edufiedler/AndreEduardoEzequiel/images/03_tampa_descobeta.jpeg

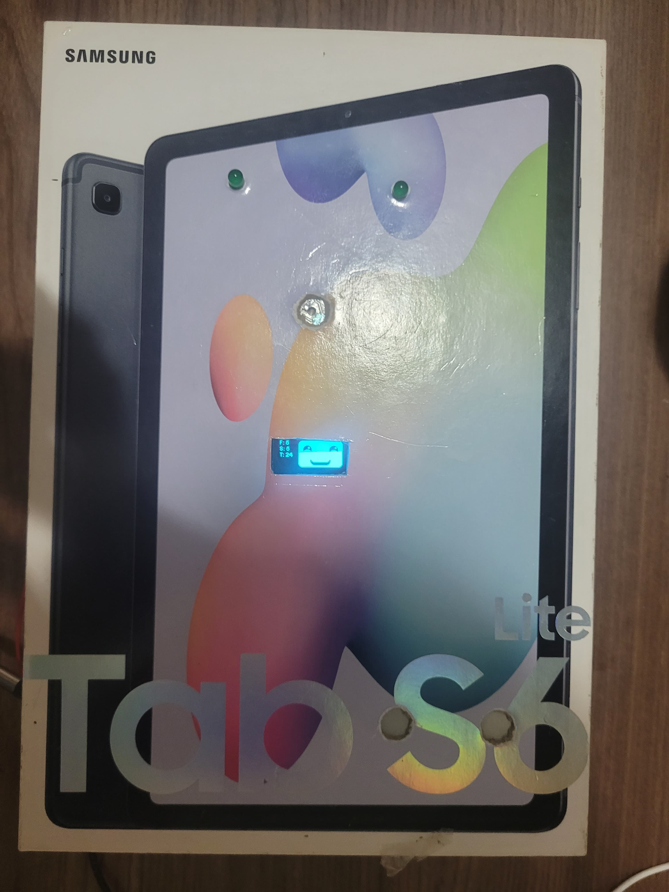
images/03_tampa_descobeta.jpeg
