edufiedler/AndreEduardoEzequiel/(threads)

Thread 1 (2023-11-17):

conteúdo

FNakano, 2023-11-17:
Caros, poderiam adicionar conteúdo?
   Sei que vocês tem testado alguns sensores e exemplos de codigo. Poderiam registrar os testes no formato de diário e documentar a proposta do pet virtual, se possivel descrever as funcionalidades desejadas e ligar com os testes...
att.
