edufiedler/AndreEduardoEzequiel/prototipo.pdf

214 | 25 | Aparência do tamagotchi Cotas para posicionamento dos equipamentos na caixa

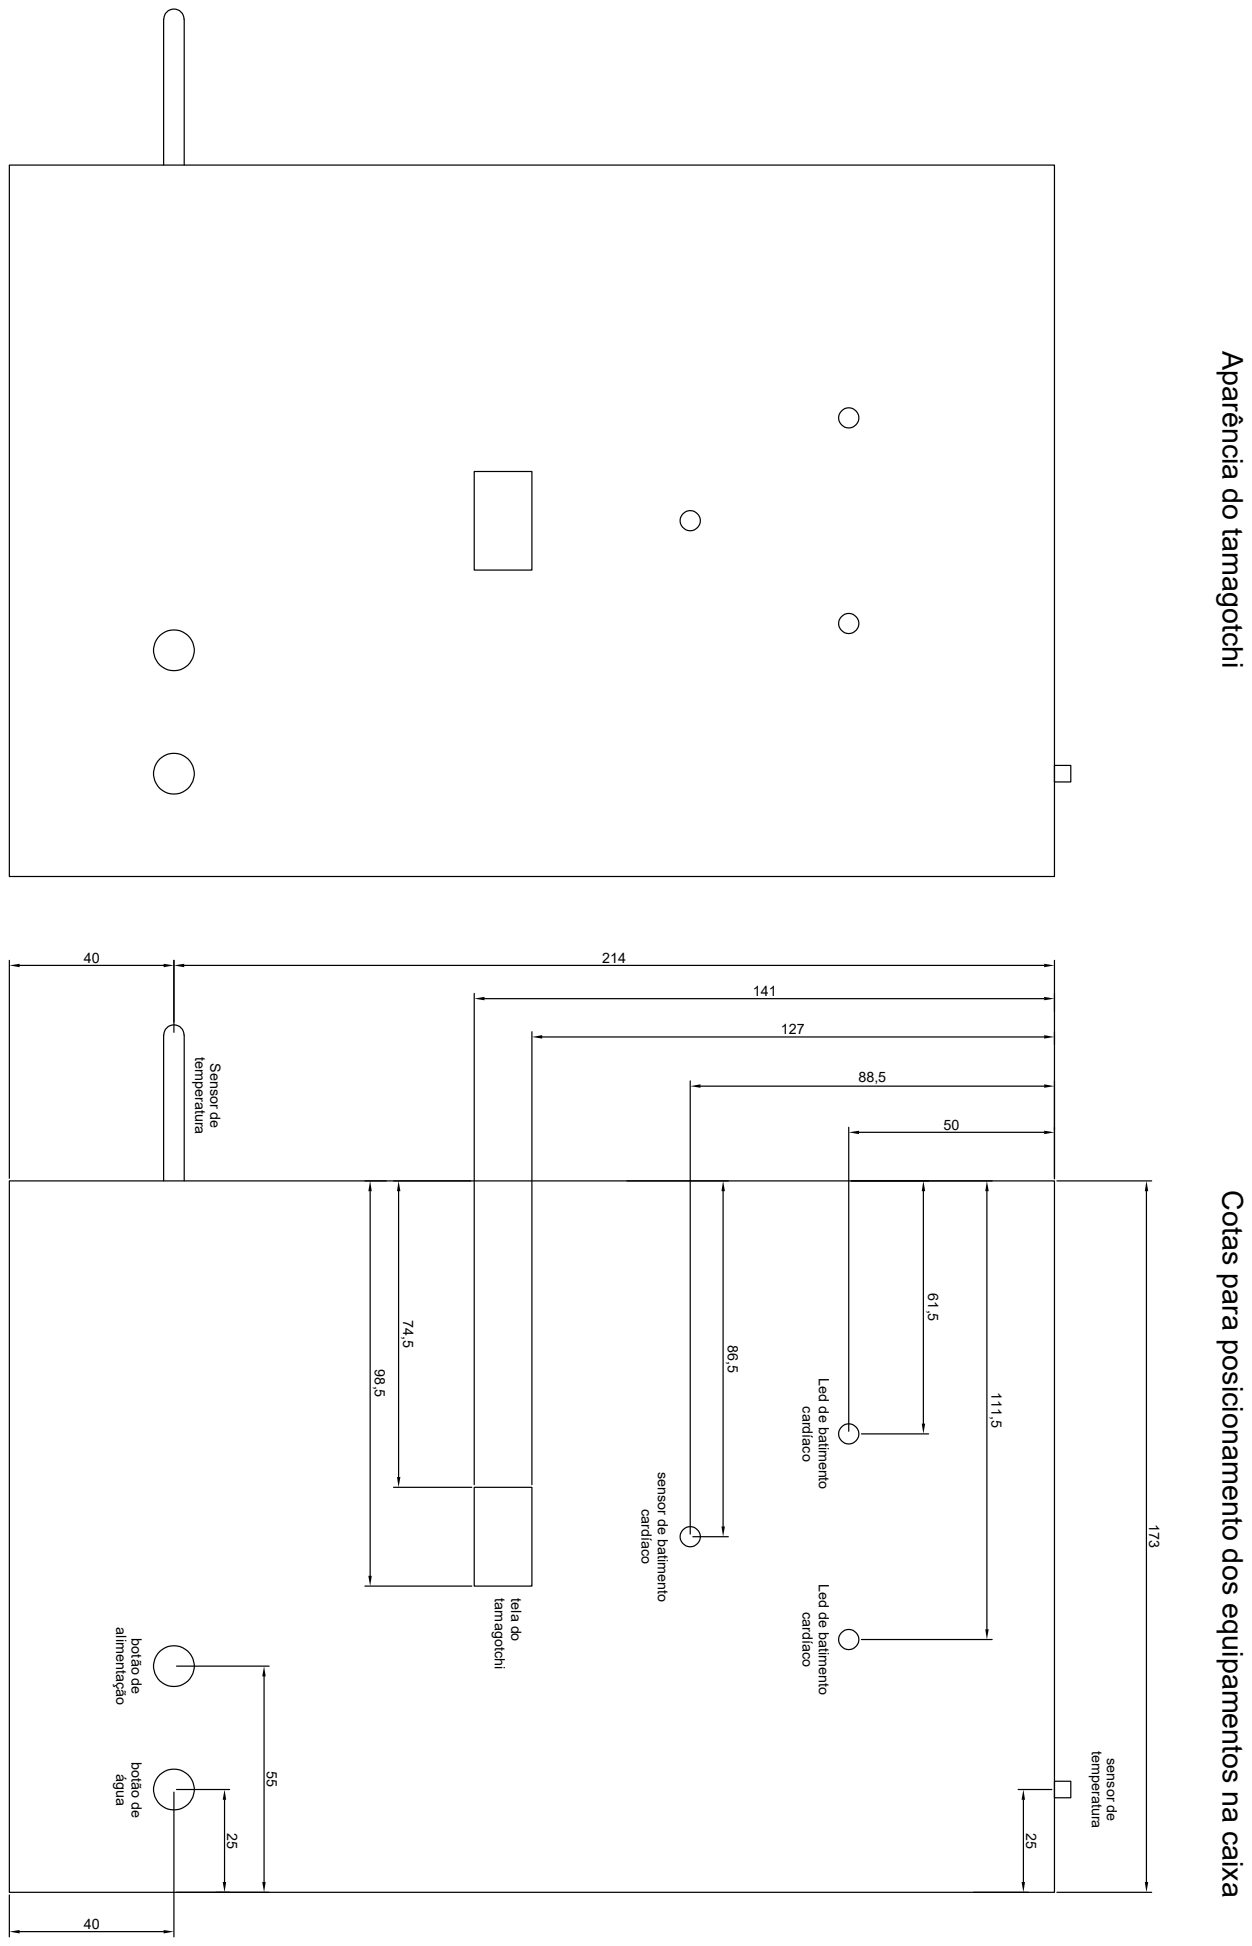
[picture p5: page 1]
cardíaco sensor de batimentotamagotchi tela do temperatura Sensor de água botão de alimentação botão de

cardíaco Led de batimento cardíaco Led de batimento temperatura sensor de 61,5 173
