edufiedler/AndreEduardoEzequiel/(commit log)

2023-12-01 Protótipos de Código
    Códigos para os sensores de batimentos cárdiacos e de temperatura
2023-12-01 Protótipo de Código
    Exemplo do sensor MPU-9250 (acelerômetro, giroscópio, bússula e temperatura)
2023-12-01 Protótipo de Código
    Busca a data e o horário pela rede wifi e após sincronizar o relógio interno desliga o wifi.
2024-01-22 servidor básico com sistema de arquivos
2024-01-22 adicionado sensor de movimentos e reoganização do código.
2024-01-23 Adicionado sensores de temperatura
2024-01-29 Inclusão do Sensor de Batimentos
    [partitions.csv]
2024-01-29 Pequena alteração em como os batimentos são medidos
2024-01-31 Implementação do registro de temperatura
2024-02-01 Funções de Tela e Comportamento
2024-02-02 Incuído passo a passo da primeira execução
2024-02-02 pequeno ajuste no tempo de resposta do servidor
    [partitions.csv]
2024-02-02 efeitoAdverso foi mudado de bool para char
2024-02-02 pequena mudaça no log
2024-02-02 Tirei o output pin. Agora o sensor de pulso estará ligado direto no VCC.
2024-02-02 Tire o output pin
2024-02-02 usando a variável global em vez de declarar novamente na função getTempExternal()
2024-02-02 não usará mais a partitions.csv e não o monitor de batimentos não usará mais o GPIO 16
2024-02-02 Correção de comportamento da função calor
2024-02-02 Redução de fonte de aviso de troca de estado
2024-02-02 Update README.md
    correção de texto
